AerospaceVillage/BricksInTheAir/Smoker/Images/eSig_super_glue.png

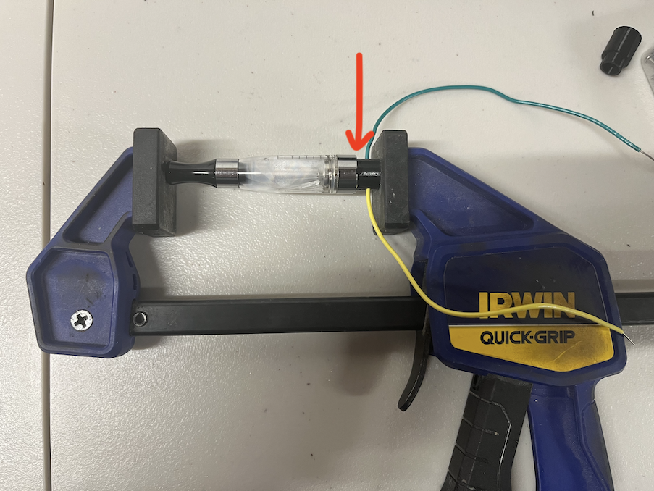
Smoker/Images/eSig_super_glue.png
