AerospaceVillage/BricksInTheAir/3D/bia_kit_base.FCStd

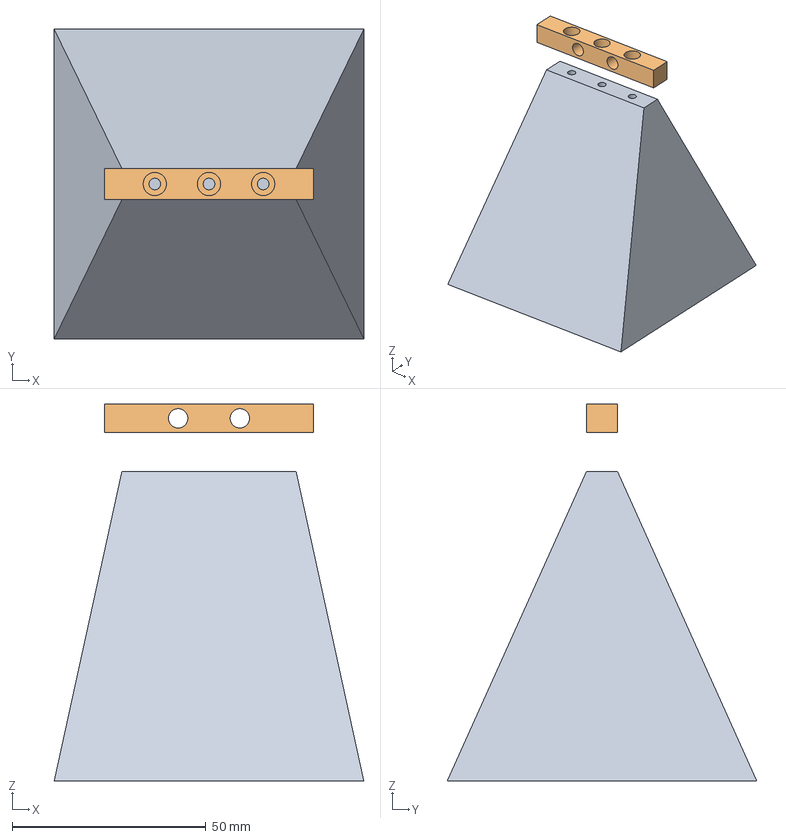
[picture p18: CAD file, 2024-05-07]
3D/bia_kit_base.FCStd
80.0 x 80.0 x 97.4 mm
BIA_Kit_stand
BIA_stand_attachment
BIA_stand_attachment (Meshed)
