AerospaceVillage/BricksInTheAir/Smoker/3D/Tubing_Attachment (Meshed).stl

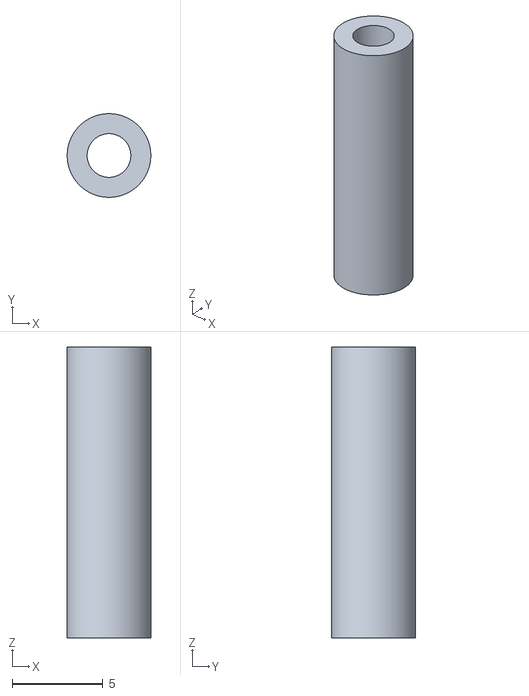
[picture p19: CAD file, 2024-05-15]
Smoker/3D/Tubing_Attachment (Meshed).stl
4.60 x 4.60 x 16.0
