AerospaceVillage/BricksInTheAir/Smoker/3D/smoker_parts.FCStd

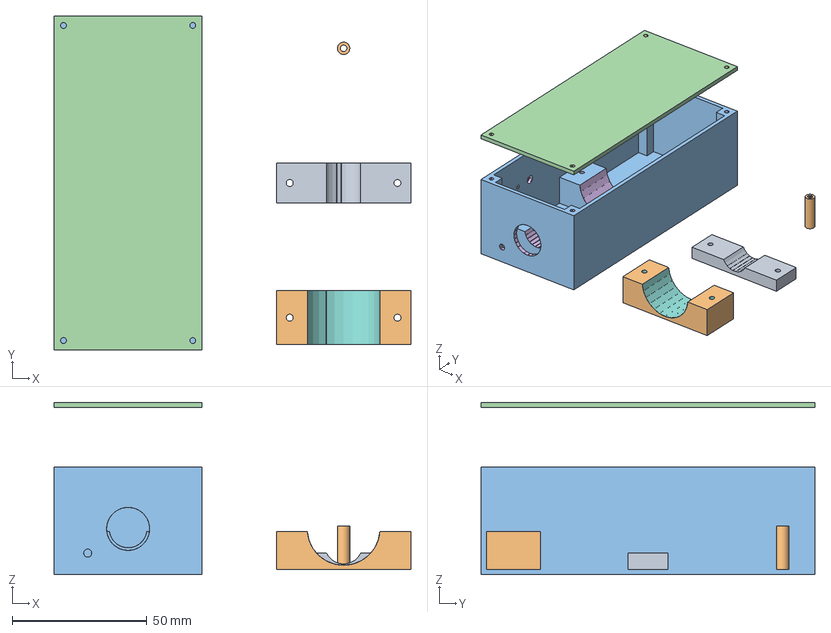
[picture p20: CAD file, 2024-05-15]
Smoker/3D/smoker_parts.FCStd
132.5 x 124.0 x 64.0 mm
chamber
pump
Enclosure
Enclosure_lid
Tubing_Attachment
Enclosure (Meshed)
Enclosure_lid (Meshed)
pump (Meshed)
chamber (Meshed)
Tubing_Attachment (Meshed)
