AerospaceVillage/BricksInTheAir/Smoker/DDS_Version/PCB/Fogger_Power_CTRL.kicad_pcb

## KiCad design Smoker/DDS_Version/PCB/Fogger_Power_CTRL.kicad_pcb (2024-05-07)

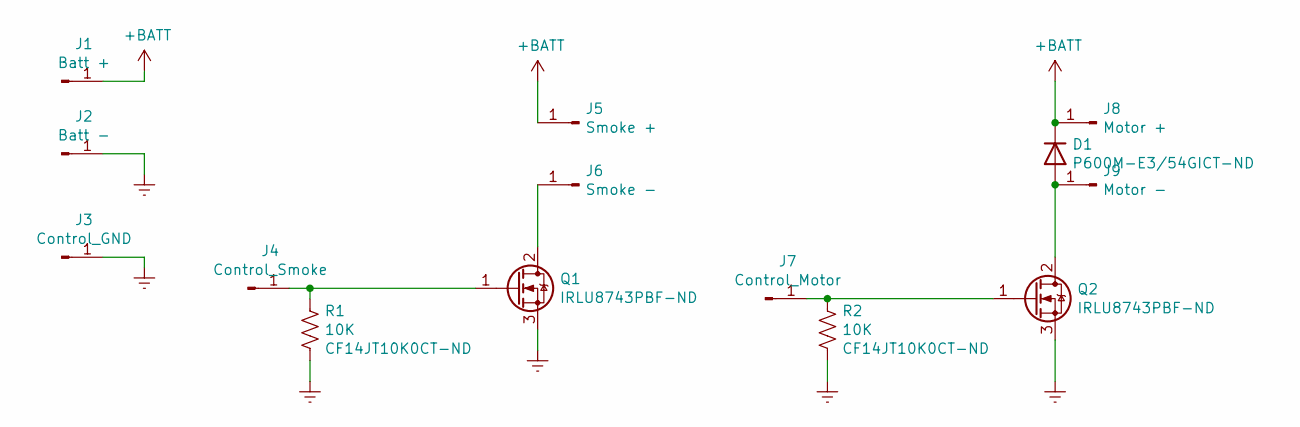
[picture p21: schematic Fogger_Power_CTRL.sch, Fogger Control]

Parts:
D1: NA; D_P600_R-6_P12.70mm_Horizontal; MFG PN P600M-E3/54GICT-ND
J1: Batt +; SolderWire-2.5sqmm_1x01_D2.4mm_OD4.4mm; MFG PN NA
J2: Batt -; SolderWire-2.5sqmm_1x01_D2.4mm_OD4.4mm; MFG PN NA
J3: Control_GND; SolderWire-2.5sqmm_1x01_D2.4mm_OD4.4mm; MFG PN NA
J4: Control_Smoke; SolderWire-2.5sqmm_1x01_D2.4mm_OD4.4mm; MFG PN NA
J5: Smoke +; SolderWire-2.5sqmm_1x01_D2.4mm_OD4.4mm; MFG PN NA
J6: Smoke -; SolderWire-2.5sqmm_1x01_D2.4mm_OD4.4mm; MFG PN NA
J7: Control_Motor; SolderWire-2.5sqmm_1x01_D2.4mm_OD4.4mm; MFG PN NA
J8: Motor +; SolderWire-2.5sqmm_1x01_D2.4mm_OD4.4mm; MFG PN NA
J9: Motor -; SolderWire-2.5sqmm_1x01_D2.4mm_OD4.4mm; MFG PN NA
Q1, Q2: IRLU8743PBF-ND; TO-251-3-1EP_Horizontal_TabDown; MFG PN IRLU8743PBF-ND
R1, R2: 10K; R_Axial_DIN0207_L6.3mm_D2.5mm_P10.16mm_Horizontal; MFG PN CF14JT10K0CT-ND

Connections:
+BATT: D1.1 (K), J1.1, J5.1, J8.1
GNDREF: J2.1, J3.1, Q1.3 (S), Q2.3 (S), R1.2, R2.2
unnamed: D1.2 (A), J9.1, Q2.2 (D)
unnamed: J4.1, Q1.1 (G), R1.1
unnamed: J6.1, Q1.2 (D)
unnamed: J7.1, Q2.1 (G), R2.1

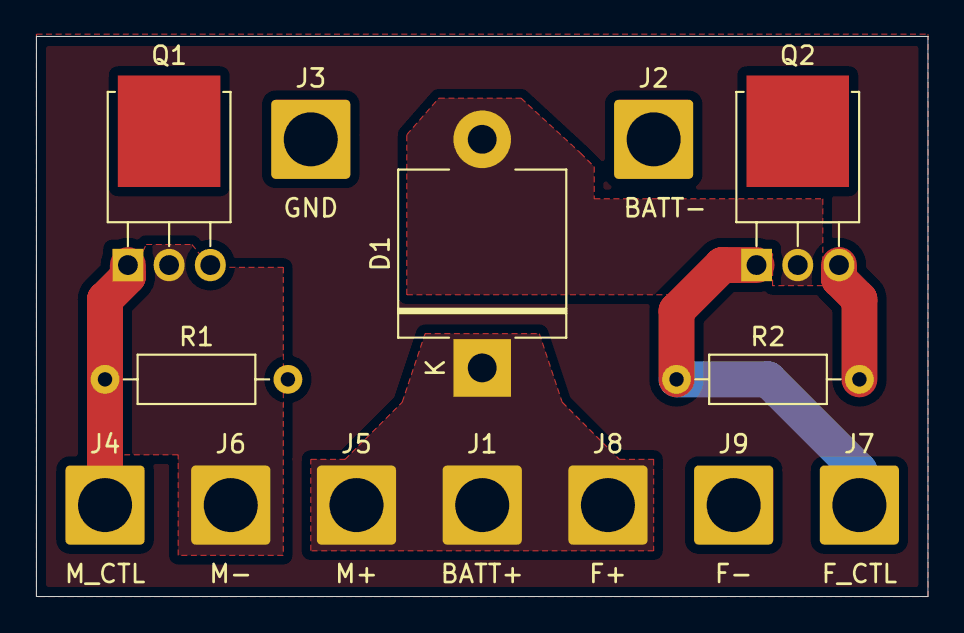
[picture p22: board Fogger_Power_CTRL.kicad_pcb from above]

Board: 2 copper layers, 49.5 x 31.1 mm, 14 parts (0 on the bottom side), 6 nets.
