AerospaceVillage/BricksInTheAir/(commit log)

2024-05-07 Smoker Enclosure Updates
    [Fogger_Power_CTRL-B_Cu.gbr, Fogger_Power_CTRL-B_Mask.gbr, Fogger_Power_CTRL-B_Paste.gbr, Fogger_Power_CTRL-B_SilkS.gbr, Fogger_Power_CTRL-Edge_Cuts.gbr, Fogger_Power_CTRL-F_Cu.gbr, Fogger_Power_CTRL-F_Mask.gbr, Fogger_Power_CTRL-F_Paste.gbr]
2024-05-07 Updated Smoker Enclosure
2024-05-15 eSig Modification Instructions
    [Tubing_Attachment (Meshed).stl, smoker_parts.FCStd]
